jimbruges/xgoduck_hardware/media/back_cover/boss_cable_closeup.png

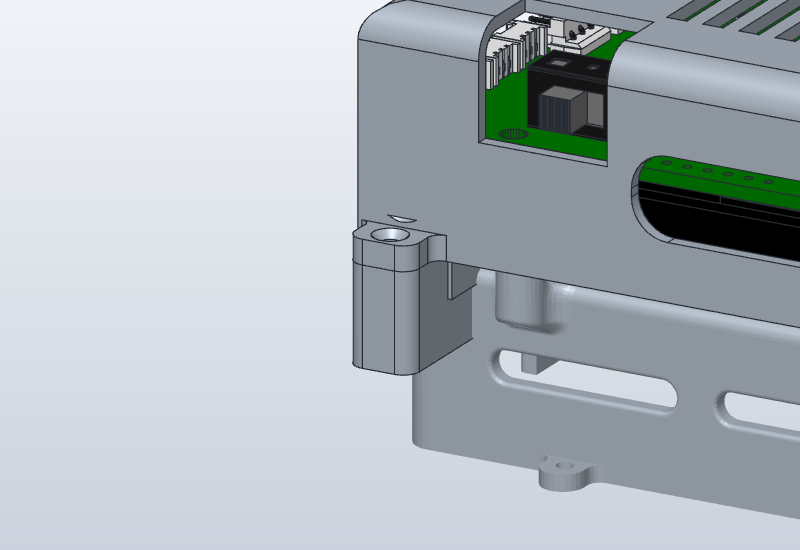
media/back_cover/boss_cable_closeup.png
