jimbruges/xgoduck_hardware/media/back_cover/boss_far_closeup.png

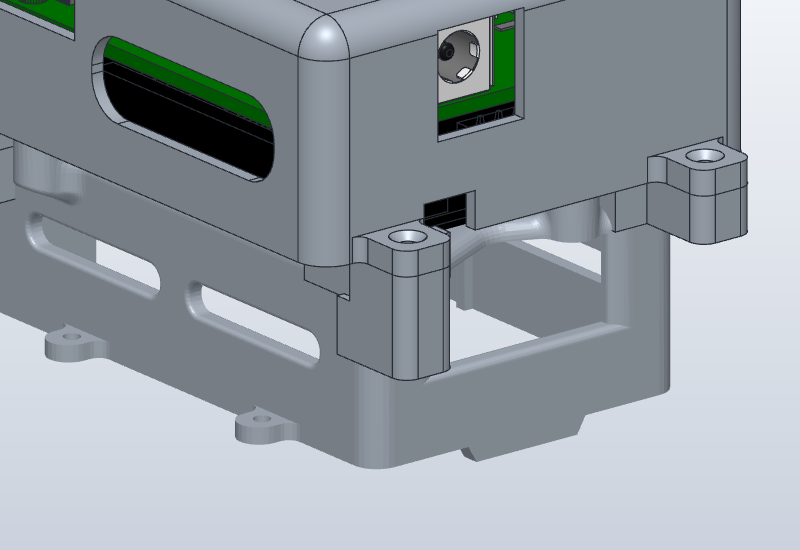
media/back_cover/boss_far_closeup.png
