jimbruges/xgoduck_hardware/structure/battery_mount.stl

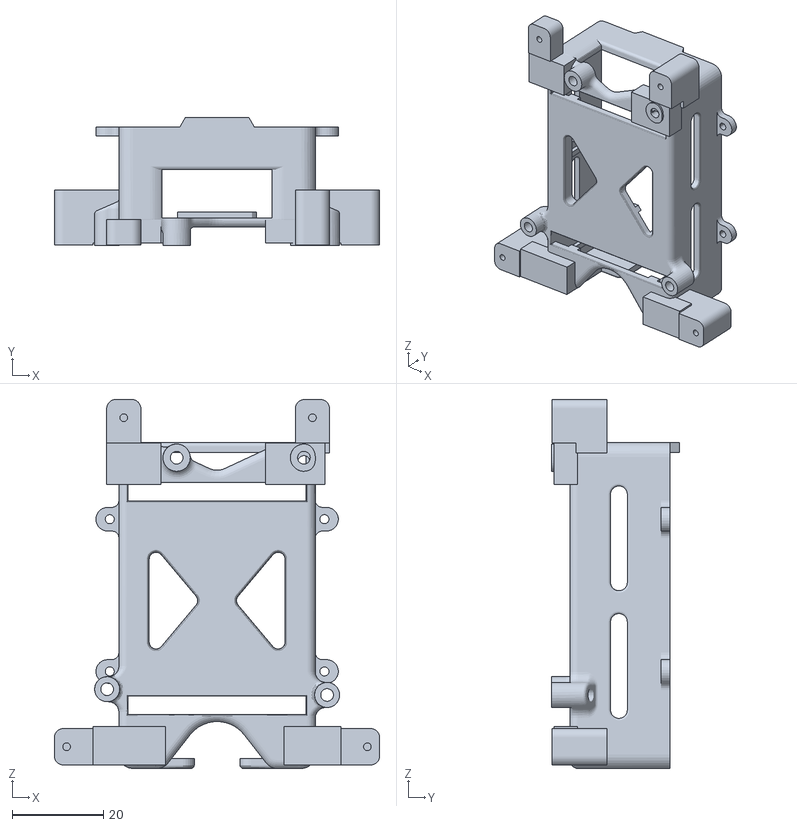
[picture p7: CAD file, 2026-10-20]
structure/battery_mount.stl
71.4 x 28.0 x 81.0
