jimbruges/xgoduck_hardware/structure/source/back_cover.step

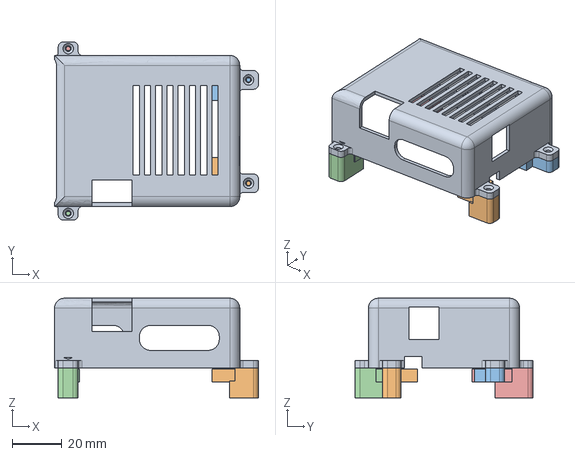
[picture p8: CAD file, 2026-10-20]
structure/source/back_cover.step
81.7 x 71.4 x 39.9 mm
