jimbruges/xgoduck_hardware/(list of files, cad)

Other CAD files:
structure/assembly/xgoduck_full_assembly.step
structure/back_cover.stl
