jimbruges/xgoduck_hardware/docs/PRINTING.md

# Printing inventory

[Project](../readme.md) · [Build guide](BUILD_GUIDE.md)

Quantities below follow the repository naming rule: `2x_` means two copies; other files default to one for planning and require confirmation against the assembly. Left/right files are distinct. Original filenames, including `mouth_buttom_tpu.stl`, are preserved so links remain compatible.

| File | Planned copies | Material note |
| --- | ---: | --- |
| [2x_ankle_axis.STL](../structure/2x_ankle_axis.STL) | 2 | Rigid material: confirm profile |
| [2x_foot_bottom_tpu.stl](../structure/2x_foot_bottom_tpu.stl) | 2 | TPU indicated by filename |
| [2x_hip_rol_output.stl](../structure/2x_hip_rol_output.stl) | 2 | Rigid material: confirm profile |
| [2x_hip_rol_shell.stl](../structure/2x_hip_rol_shell.stl) | 2 | Rigid material: confirm profile |
| [2x_hip_yaw2rol.STL](../structure/2x_hip_yaw2rol.STL) | 2 | Rigid material: confirm profile |
| [2x_neck.stl](../structure/2x_neck.stl) | 2 | Rigid material: confirm profile |
| [2x_shank.stl](../structure/2x_shank.stl) | 2 | Rigid material: confirm profile |
| [2x_thigh_support.stl](../structure/2x_thigh_support.stl) | 2 | Rigid material: confirm profile |
| [battery.stl](../structure/battery.stl) | 1 | Rigid material: confirm profile. **This fork: print [battery_mount.stl](../structure/battery_mount.stl) instead**, which is the same case with screw bosses for the back cover |
| [battery_mount.stl](../structure/battery_mount.stl) | 1 | Fork addition, replaces `battery.stl`. PETG, 3+ perimeters; print body side down like `battery.stl`, with small supports under the two cable-end bosses. See [BACK_COVER.md](BACK_COVER.md) |
| [back_cover.stl](../structure/back_cover.stl) | 1 | Fork addition. PETG; already oriented roof down, no supports. Fixed with 4 × M2 × 6 countersunk self-tapping screws (BOM item 7). See [BACK_COVER.md](BACK_COVER.md) |
| [body.stl](../structure/body.stl) | 1 | Rigid material: confirm profile |
| [body_left_shell.stl](../structure/body_left_shell.stl) | 1 | Rigid material: confirm profile |
| [body_right_shell.stl](../structure/body_right_shell.stl) | 1 | Rigid material: confirm profile |
| [eye.stl](../structure/eye.stl) | 1 | Rigid material: confirm profile |
| [eye_shell.stl](../structure/eye_shell.stl) | 1 | Rigid material: confirm profile |
| [head.stl](../structure/head.stl) | 1 | Rigid material: confirm profile |
| [head_pitch.stl](../structure/head_pitch.stl) | 1 | Rigid material: confirm profile |
| [head_servo_support.stl](../structure/head_servo_support.stl) | 1 | Rigid material: confirm profile |
| [head_shell.stl](../structure/head_shell.stl) | 1 | Rigid material: confirm profile |
| [head_yaw.STL](../structure/head_yaw.STL) | 1 | Rigid material: confirm profile |
| [hip_yaw_support.STL](../structure/hip_yaw_support.STL) | 1 | Rigid material: confirm profile |
| [jaw.stl](../structure/jaw.stl) | 1 | Rigid material: confirm profile |
| [left_foot.stl](../structure/left_foot.stl) | 1 | Rigid material: confirm profile |
| [mouth_buttom_tpu.stl](../structure/mouth_buttom_tpu.stl) | 1 | TPU indicated by filename |
| [mouth_up_tpu.stl](../structure/mouth_up_tpu.stl) | 1 | TPU indicated by filename |
| [right_foot.stl](../structure/right_foot.stl) | 1 | Rigid material: confirm profile |
| [thigh_left_shell.stl](../structure/thigh_left_shell.stl) | 1 | Rigid material: confirm profile |
| [thigh_right_shell.stl](../structure/thigh_right_shell.stl) | 1 | Rigid material: confirm profile |

## Print profile still required

The release needs tested values for material brand/type, nozzle, layer height, walls, infill, supports, orientation, scale and tolerances, with finished-part photographs. TPU hardness is also unspecified. No recommended print time or filament mass has been measured here.

Before a full print, check one servo mount and one bearing seat, inspect left/right orientation and verify cable clearance. Record your settings and report fit results with the part filename. A slicer project from a different revision is not a verified profile for these STLs.

STEP and SolidCraft sources for the fork's back cover and battery-mount bosses are in [structure/source/](../structure/source/), and a whole-robot fit-check assembly (SolidCraft and STEP) is in [structure/assembly/](../structure/assembly/). Neither folder holds print files.
