jimbruges/xgoduck_hardware/(commit log)

2026-10-19 Add clip-on UNO Q cover and whole-robot fit-check assembly
    - cad/uno_q_cover: retrofit snap-on cover for the UNO Q + expansion
    board stack (STL, STEP, editable SolidCraft source)
    - Whole-robot SolidCraft assembly from the xgoduck_rl zero-pose model
    with UNO Q, expansion board, battery case, 2S 18650 pack and cover,
    interference-checked incl. full inward hip roll
    - README: describe fork additions; measured robot mass 825 g
    - Ignore local superseded cover iterations
    [unoq_cover_v5.step, unoq_cover_v5.stl]
2026-10-19 Move UNO Q cover into structure/ and docs/
    - Print file: structure/uno_q_cover.stl
    - STEP/SolidCraft sources: structure/source/
    - Whole-robot fit-check assembly: structure/assembly/
    - Renders: media/uno_q_cover/; write-up: docs/UNO_Q_COVER.md
    - Update readme, README_CN and PRINTING inventory; remove cad/
    - Fix PRINTING link for the renamed 2x_hip_yaw2rol.STL
    [uno_q_cover.step, uno_q_cover.stl]
2026-10-19 docs: link companion forks and note training use of the assembly
    - readme: companion runtime (calibration-tools) and RL (cad-battery) forks
    - UNO_Q_COVER: battery sits between the body and the UNO Q stack;
    add the trunk-frame positions and mass estimates used for training
2026-10-19 Add STEP export of the whole-robot fit-check assembly
    structure/assembly/xgoduck_full_assembly.step (AP242): the UNO Q,
    expansion board, cover and 18650 cells are exact solids. The robot
    links and battery case are faceted bodies with planar triangle faces.
    Part names, colours and placement match the SolidCraft assembly.
    Verified by re-importing: 358 bodies, no errors, matching bounding
    boxes.
    [xgoduck_full_assembly.step]
2026-10-20 Replace clip-on UNO Q cover with screw-on back cover and battery mount
    The clip-on cover passed knocks straight to the boards. The new rigid
    back cover touches only four bosses on a modified battery case, keeps
    at least 2 mm from the boards, and is held by 4 x M2x6 countersunk
    self-tapping screws driven from the back. All bosses and screw holes
    stay above the battery plate, clear of the cells.
    - structure/back_cover.stl, structure/battery_mount.stl (print instead
    of battery.stl), STEP and SolidCraft sources in structure/source/
    - Whole-robot assembly (SolidCraft and STEP) updated with the new parts;
    the UNO Q stack now sits on the battery case standoffs, 6.9 mm closer
    to the body than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
    [back_cover.step, back_cover.stl, battery_mount.stl, uno_q_cover.step, uno_q_cover.stl, xgoduck_full_assembly.step]
